zawudui/USB-ParallelPort-Marker-Box/hardware/enclosure/r7.2/snap-fit-pa12/设计说明.md

# C 版：两件一体打印的可拆卡扣外壳

状态：首件试装原型。结构已经按可打印实体设计，实际扣合力、拆装寿命和线缆适配尚需实物确认。

## 送打清单

成品只需打印两件，同一种材料：

| 文件 | 数量 | 内容 |
|---|---:|---|
| `base_r72_snap.stl` | 1 | 底壳、承托柱、定位销、侧向限位块、解锁窗口均一体打印 |
| `lid_r72_snap.stl` | 1 | 上盖、四个弹性卡扣、PCB 上方限位柱、对合定位唇边均一体打印 |

采用 **本色、非增强 PA12 尼龙，MJF 或 SLS**。无需螺丝、螺母、铜柱、泡棉、胶水、垫片、单独卡扣件或表面涂层。正常清粉和去除打印残留属于打印后清理。

STL 单位 mm，100% 比例；底壳和上盖已分别放到 Z=0，上盖已翻转。两件分别打印，不要把 `assembled_r72_snap.step` 作为一整个打印件。STEP 保留 PCB 装配坐标，因此与打印 STL 的姿态不同。

此版卡扣以 PA12 粉末打印为设计工艺；不要直接替换成普通光敏树脂、PLA，或将同一文件视为已经验证过的 FDM/PETG 方案。

## 结构与尺寸

- 合盖外形 **171 × 144 × 33 mm**。相对 B 版加宽 8 mm，为卡扣向内弯曲留空间；PCB 和接口的基准位置沿用原坐标。
- 接口端壁、底板和顶板厚 2.8 mm，两条长侧壁厚 2.6 mm；四个卡扣的弹性臂厚 1.2 mm、宽 8 mm，根部圆角 0.8 mm。弹性臂与背后侧壁之间留 0.6 mm 开放间隙，便于清粉和按压活动。
- 卡扣通过底壳两侧窗口解锁，按钮与壳体一起打印。标号 1、2 表示两组卡扣。
- 对合唇边每侧留 0.4 mm 标称间隙，用于导向和承受横向载荷。
- PCB 下方有四个工艺边承托柱及原主板承托台；两个对角孔采用 Ø1.4 mm 圆定位销和沿孔距方向放松的椭圆定位销，另两个柱只承托。
- 四个上盖限位柱下端 Z=2.05 mm。PCB 标称厚 1.6 mm 时留 0.45 mm 竖向间隙，不要求硬压紧，不使用泡棉。开盖后可以直接取出 PCB。
- 工艺边固定孔来自首板 CAM 数据（交易编号已从公开版移除）：Ø2.05 mm NPTH；外壳坐标为 `(5, 2.5)`、`(145, 2.5)`、`(5, -120.5)`、`(150, -120.5)` mm。承托和上方限位相互对应，避开 V-CUT 切槽。

## 装配与拆卸

1. 先空壳试扣，确认四扣进入窗口、合缝贴合；通过两侧窗口按压卡扣，均匀抬起上盖，确认能拆开。
2. 将 PCB 两个对角定位孔套入定位销，板底落在承托面上。板子应自然放下，不应靠挤压或掰弯工艺边装入。
3. 将上盖唇边对正底壳，沿四个卡扣位置逐步按合，确认四扣均入位。
4. 实际插拔 USB-C、DB25，并确认配套插头外壳和锁紧旋钮有空间。
5. 拆卸时通过侧窗向内按压卡扣并轻抬上盖，可先解除一组、保持该端略微抬起，再解除另一组。不要单侧大角度掀盖，也不要拉扯 PCB。

`optional_coupon/` 下的两个 STL 是从同一套实际卡扣与窗口裁出的可选试配小样。可以先用同一 PA12 工艺打印它们，检查扣合和按压手感；它们不参与成品装配，也不要求额外材料。

## 验证范围

生成程序检查：每件为有效单实体、STL 封闭及法向一致、网格与实体体积一致、合盖无刚性重叠、含真实孔位的工艺边无干涉、DB25 预留包络无干涉，并逐一核对原 PCB STEP 中的元件。

卡扣另有标称梁应变和向内变形空间的初步计算。这不是有限元分析、实际扣合力或疲劳寿命测试；文件中的间隙也不代替打印供应商的实际公差。首件需要实际装配确认。

原 PCB STEP 中 J2、U20 的实体不完整，R99、TP201、TP202、TP203 缺少实体，因此保留原有未验证标记。DB25、USB 配套线缆仍需实物试插。

## 重新生成

在当前工程环境运行：

```text
python hardware/enclosure/r7.2/snap-fit/build_snap_enclosure.py
python hardware/enclosure/r7.2/snap-fit/render_snap_review.py
```

默认生成到 `output/`。`--geometry-only` 只用于结构迭代，其报告标为未完成验证，不作为完整交付。

设计参考：[嘉立创 MJF 工艺说明](https://jlc3dp.com/help/article/what-is-multi-jet-fusion%28mjf%293d-printing)、[Protolabs 卡扣设计指南](https://www.hubs.com/knowledge-base/how-design-snap-fit-joints-3d-printing/)。这些工艺建议用于选定材料、圆角和间隙，具体本壳仍需首件试装。
