zawudui/USB-ParallelPort-Marker-Box/hardware/enclosure/r7.2/snap-fit-pa12/C_latch_section.png

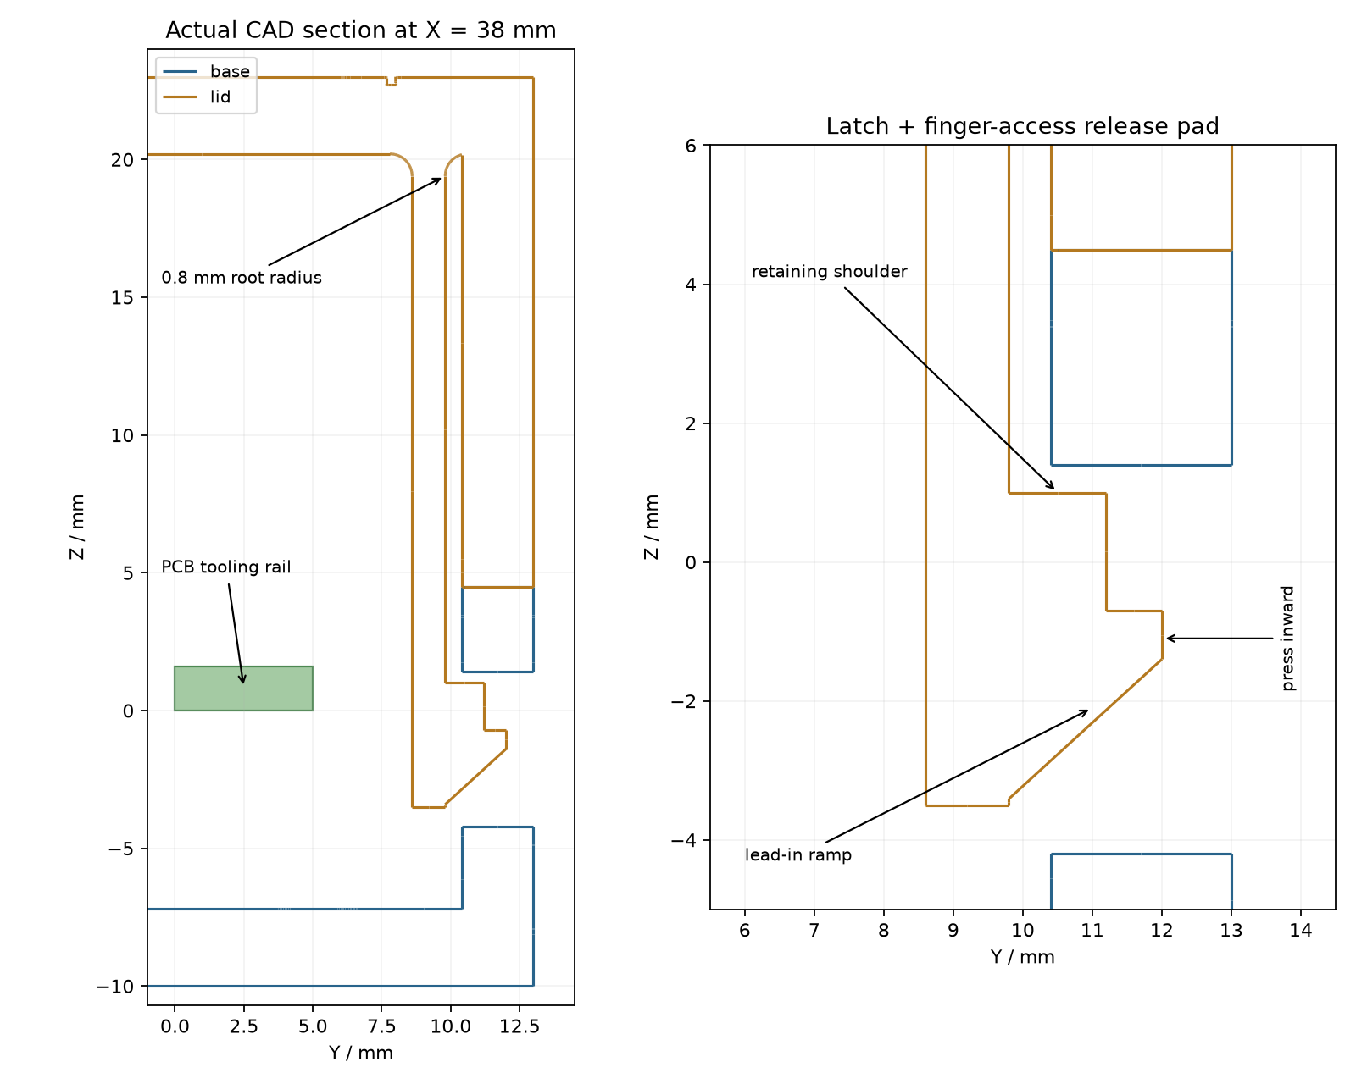
hardware/enclosure/r7.2/snap-fit-pa12/C_latch_section.png
