zawudui/USB-ParallelPort-Marker-Box/hardware/r7.2/manufacturing/bom/usb_db25_marker-bom-r7.2-by-ref.csv

Ref | Value | Footprint
C1 | 100nF | Capacitor_SMD:C_0603_1608Metric
C2 | 100nF | Capacitor_SMD:C_0603_1608Metric
C3 | 100nF | Capacitor_SMD:C_0603_1608Metric
C4 | 4.7uF | Capacitor_SMD:C_0603_1608Metric
C5 | 8.2pF | Capacitor_SMD:C_0603_1608Metric
C6 | 8.2pF | Capacitor_SMD:C_0603_1608Metric
C7 | 2.2uF | Capacitor_SMD:C_0603_1608Metric
C10 | 10uF | Capacitor_SMD:C_0603_1608Metric
C11 | 22uF | Capacitor_SMD:C_0603_1608Metric
C20 | 10uF/25V | Capacitor_SMD:C_0805_2012Metric
C21 | 10uF | Capacitor_SMD:C_0603_1608Metric
C22 | 100nF | Capacitor_SMD:C_0603_1608Metric
C23 | 100nF | Capacitor_SMD:C_0603_1608Metric
C24 | 100nF | Capacitor_SMD:C_0603_1608Metric
C25 | 100nF | Capacitor_SMD:C_0603_1608Metric
C30 | 100nF | Capacitor_SMD:C_0603_1608Metric
C31 | 100nF | Capacitor_SMD:C_0603_1608Metric
C32 | 100nF | Capacitor_SMD:C_0603_1608Metric
C33 | 100nF | Capacitor_SMD:C_0603_1608Metric
C34 | 100nF | Capacitor_SMD:C_0603_1608Metric
C35 | 100nF | Capacitor_SMD:C_0603_1608Metric
C36 | 100nF | Capacitor_SMD:C_0603_1608Metric
C37 | 100nF | Capacitor_SMD:C_0603_1608Metric
C40 | 100nF | Capacitor_SMD:C_0603_1608Metric
C201 | 10uF/25V | Capacitor_SMD:C_0805_2012Metric
C202 | 1uF/16V | Capacitor_SMD:C_0603_1608Metric
C203 | 10uF/25V | Capacitor_SMD:C_0805_2012Metric
C204 | 10uF/25V | Capacitor_SMD:C_0805_2012Metric
C205 | 100nF | Capacitor_SMD:C_0603_1608Metric
C206 | 3.3nF | Capacitor_SMD:C_0603_1608Metric
C207 | 220nF | Capacitor_SMD:C_0603_1608Metric
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
U17 | TPD2E2U06DCKR | Package_TO_SOT_SMD:SOT-323_SC-70
U18 | TPD4E05U06DQAR | Package_SON:USON-10_2.5x1.0mm_P0.5mm
U19 | TPD4E05U06DQAR | Package_SON:USON-10_2.5x1.0mm_P0.5mm
U20 | TPS61085PWR | Package_SO:TSSOP-8_4.4x3mm_P0.65mm
Y1 | 25MHz 8pF NX3225GA | Crystal:Crystal_SMD_3225-4Pin_3.2x2.5mm
