zawudui/USB-ParallelPort-Marker-Box/hardware/enclosure/r7.2/snap-fit-pa12/assembled_r72_snap.step

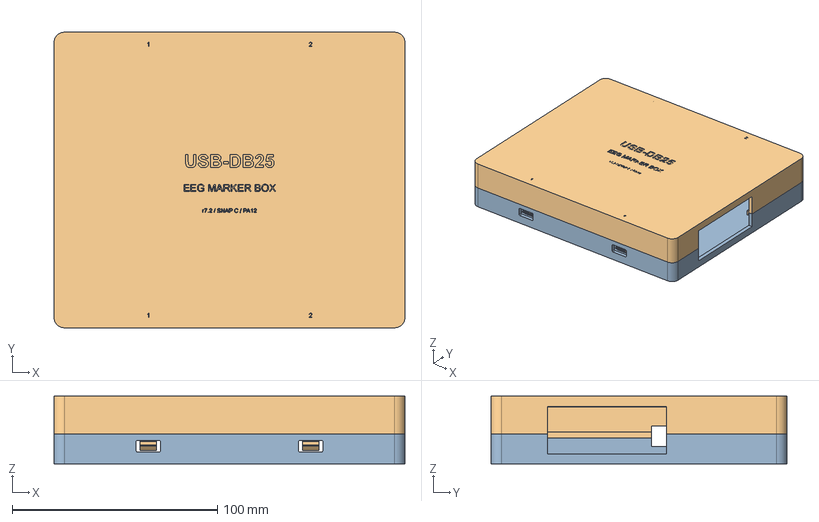
[picture p3: CAD file, 2026-11-09]
hardware/enclosure/r7.2/snap-fit-pa12/assembled_r72_snap.step
171.0 x 144.0 x 33.0 mm
BASE
LID
