zawudui/USB-ParallelPort-Marker-Box/hardware/enclosure/r7.2/first-fit/assembled_enclosure_r72.step

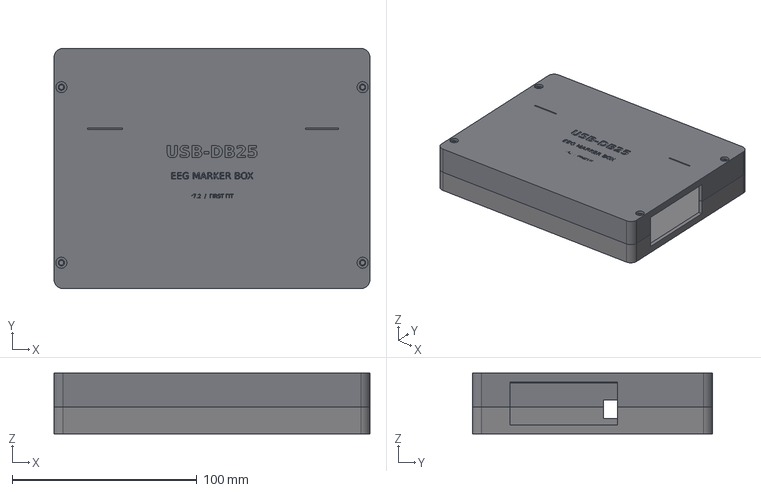
[picture p4: CAD file, 2026-11-09]
hardware/enclosure/r7.2/first-fit/assembled_enclosure_r72.step
171.0 x 130.0 x 33.0 mm
BASE
LID
