zawudui/USB-ParallelPort-Marker-Box/hardware/enclosure/r7.2/snap-fit-pa12/optional_coupon/clip_lid.stl

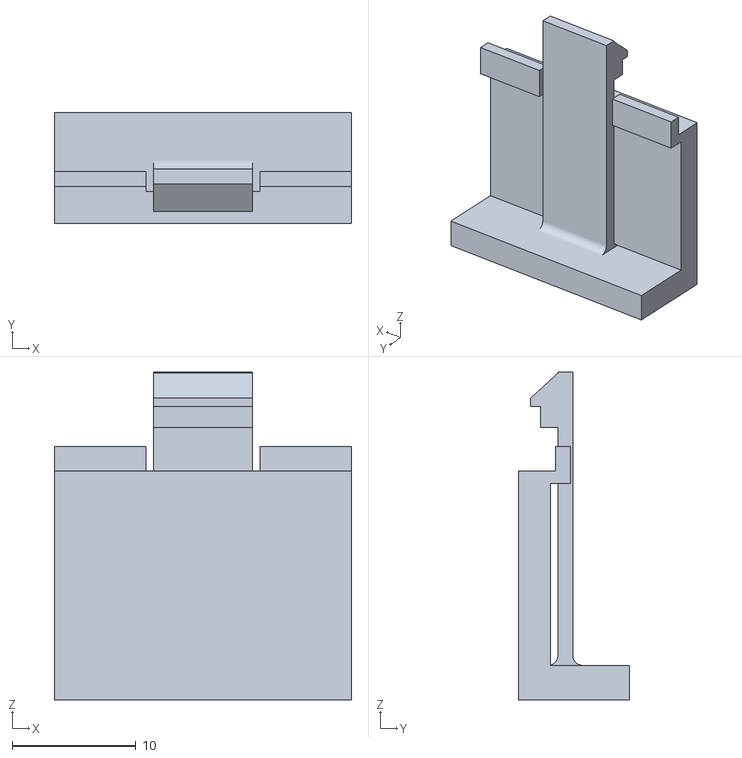
[picture p6: CAD file, 2026-11-09]
hardware/enclosure/r7.2/snap-fit-pa12/optional_coupon/clip_lid.stl
24.0 x 9.00 x 26.5
