zawudui/USB-ParallelPort-Marker-Box/hardware/enclosure/r7.2/snap-fit-pa12/lid_r72_snap.step

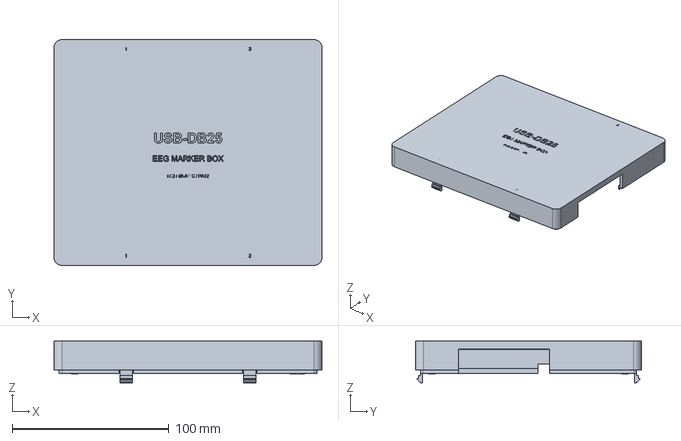
[picture p7: CAD file, 2026-11-09]
hardware/enclosure/r7.2/snap-fit-pa12/lid_r72_snap.step
171.0 x 144.0 x 26.5 mm
