zawudui/USB-ParallelPort-Marker-Box/hardware/enclosure/r7.2/snap-fit-pa12/optional_coupon/clip_base.stl

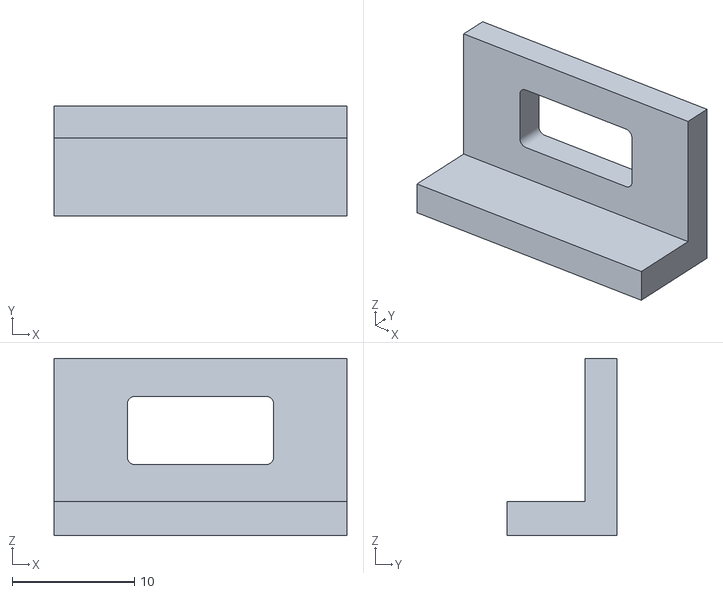
[picture p8: CAD file, 2026-11-09]
hardware/enclosure/r7.2/snap-fit-pa12/optional_coupon/clip_base.stl
24.0 x 9.00 x 14.5
