zawudui/USB-ParallelPort-Marker-Box/hardware/enclosure/r7.2/snap-fit-pa12/base_r72_snap.step

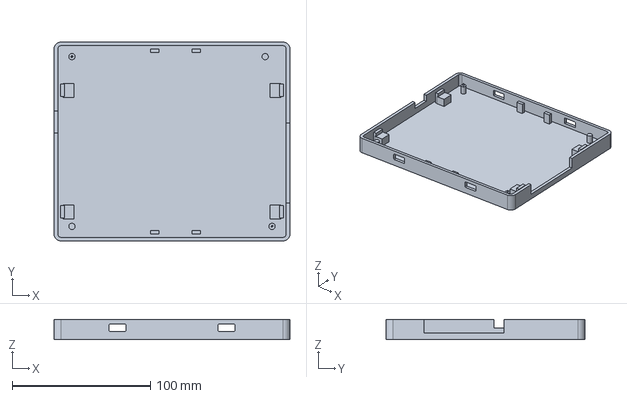
[picture p10: CAD file, 2026-11-09]
hardware/enclosure/r7.2/snap-fit-pa12/base_r72_snap.step
171.0 x 144.0 x 14.5 mm
