zawudui/USB-ParallelPort-Marker-Box/(list of files, cad)

Other CAD files:
hardware/enclosure/r7.2/first-fit/base_r72.stl
hardware/enclosure/r7.2/first-fit/lid_r72.stl
hardware/enclosure/r7.2/snap-fit-pa12/base_r72_snap.stl
hardware/enclosure/r7.2/snap-fit-pa12/lid_r72_snap.stl
