zawudui/USB-ParallelPort-Marker-Box/hardware/r7.2/manufacturing/assembly/assembly-bottom-r7.2.pdf

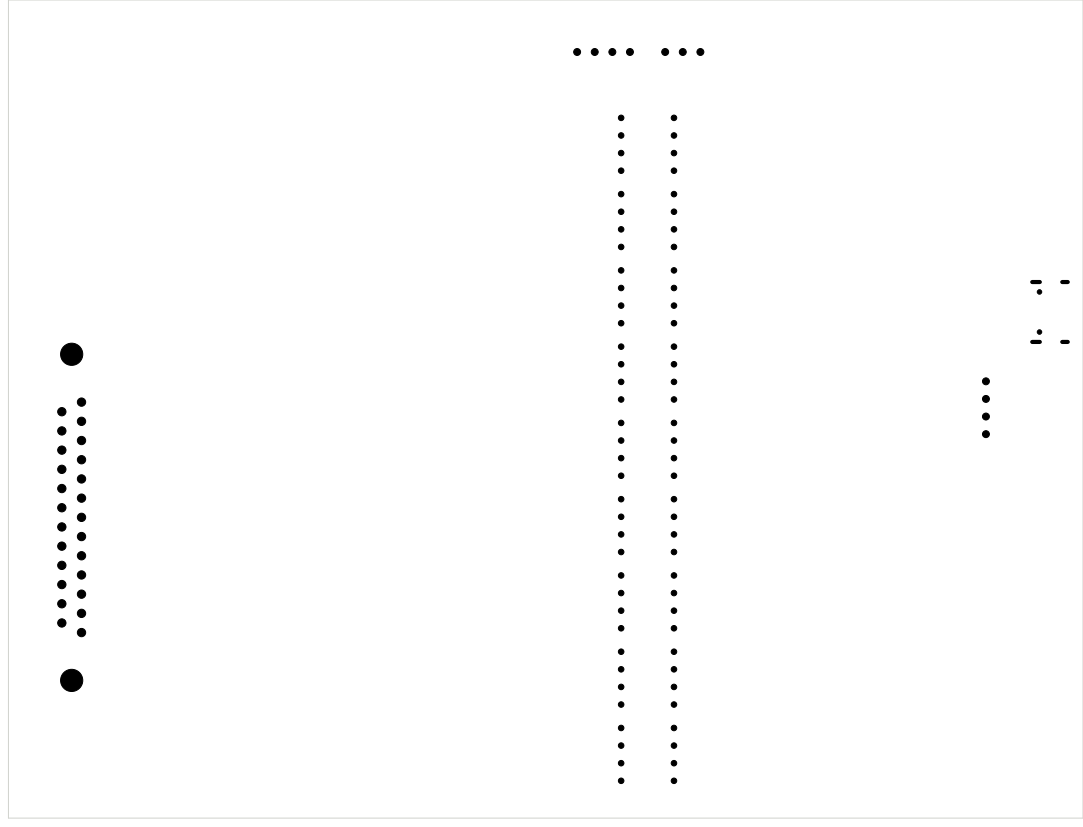
[picture p11: page 1]
