zawudui/USB-ParallelPort-Marker-Box/hardware/r7.2/manufacturing/assembly/assembly-top-r7.2.pdf

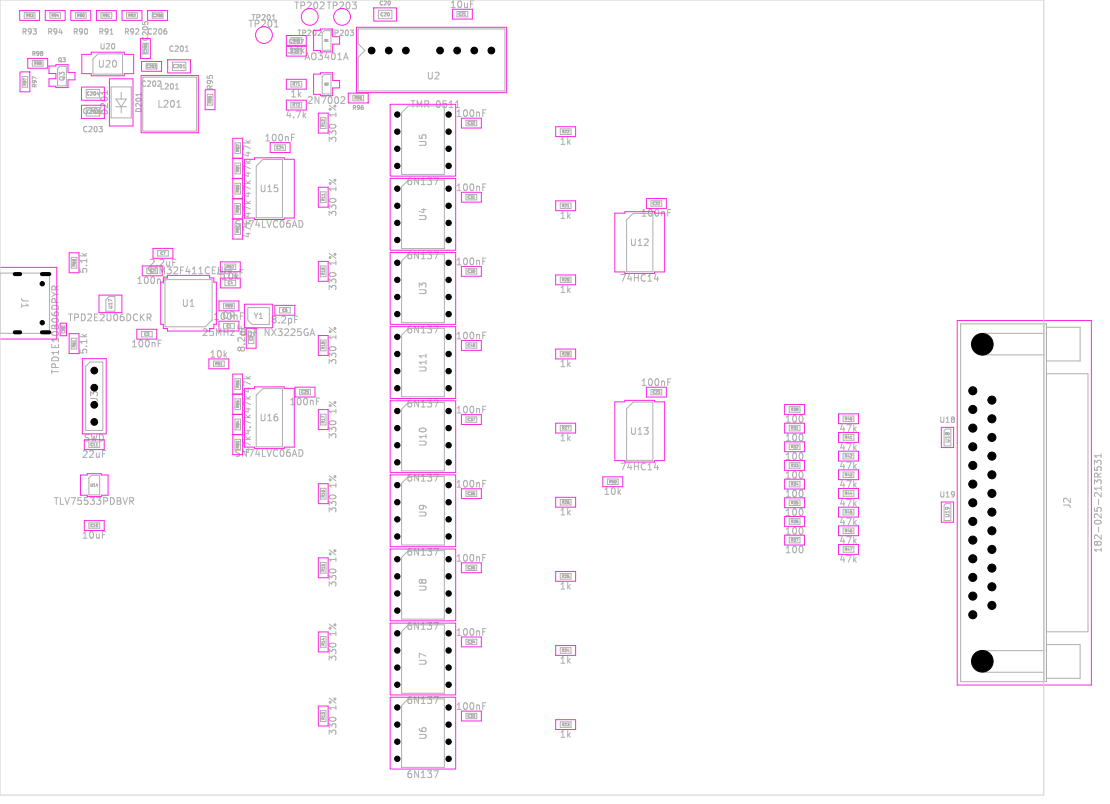
[picture p12: page 1]
