zawudui/USB-ParallelPort-Marker-Box/hardware/r7.2/manufacturing/assembly/pcb-bottom-r7.2.pdf

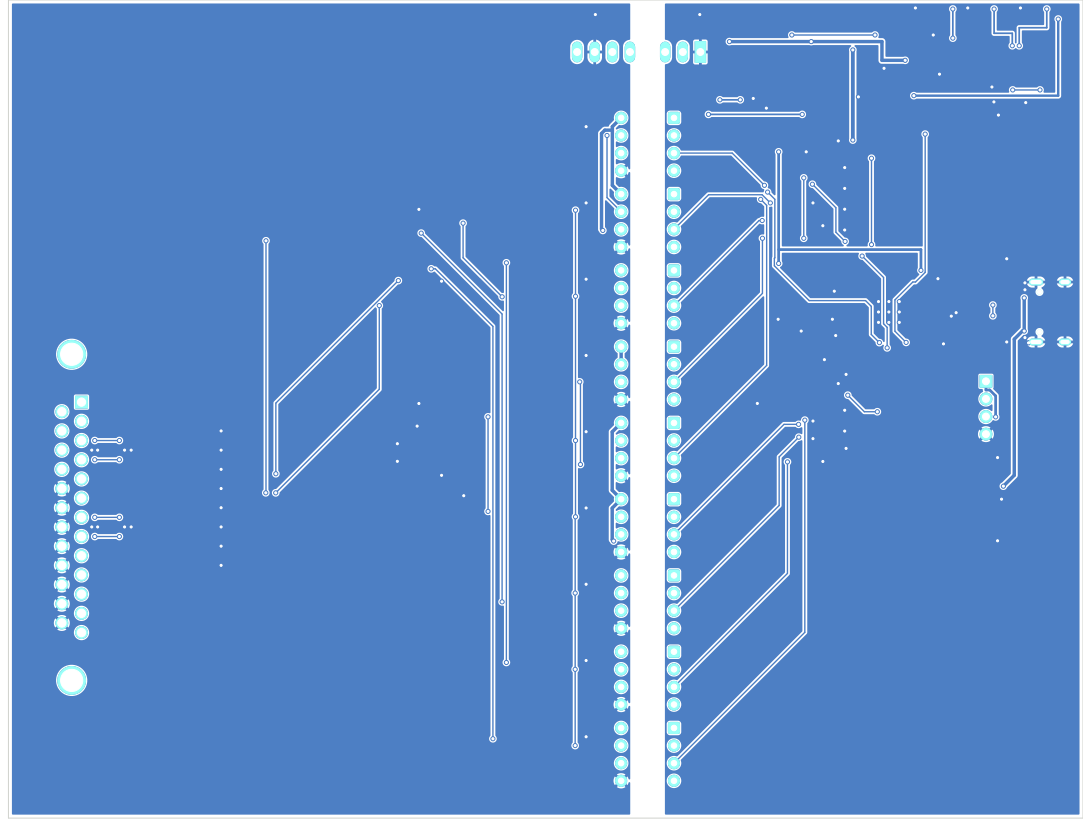
[picture p13: page 1]
