zawudui/USB-ParallelPort-Marker-Box/hardware/r7.2/manufacturing/assembly/pcb-top-r7.2.pdf

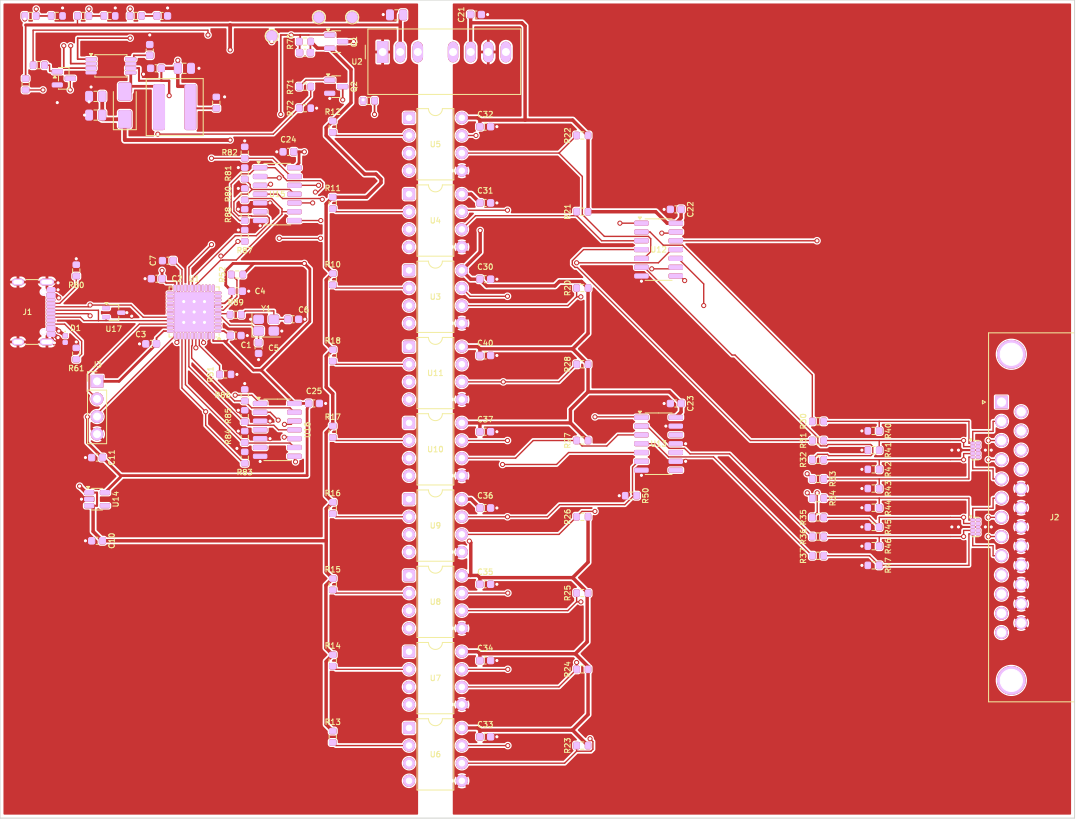
[picture p14: page 1]
