zawudui/USB-ParallelPort-Marker-Box/hardware/r7.2/manufacturing/assembly/schematic-r7.2.pdf

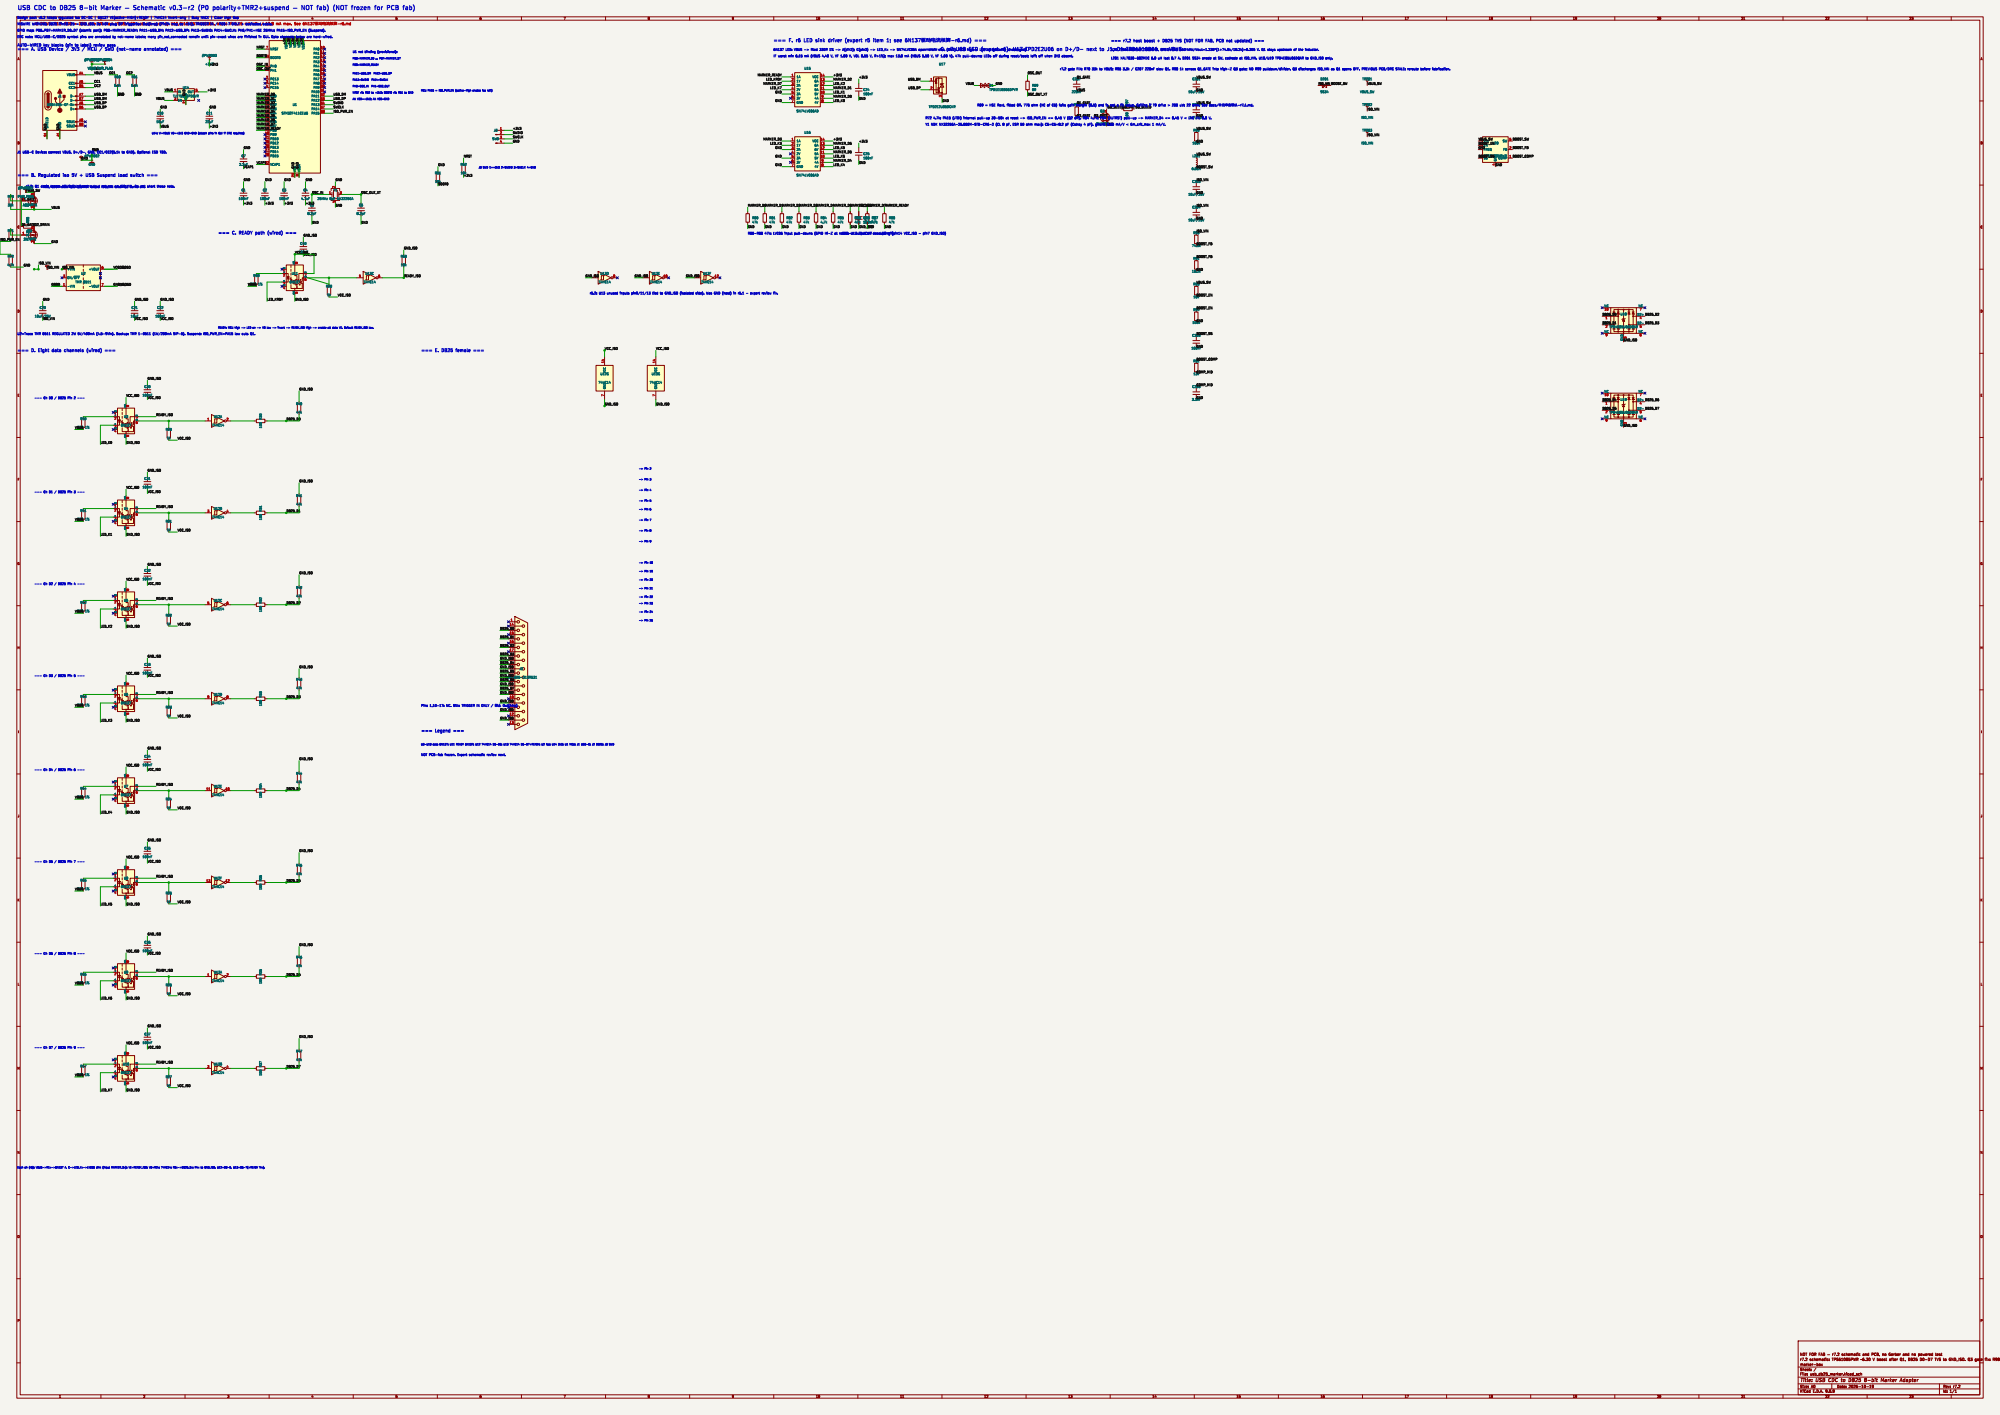
[picture p15: page 1]

1 VDD 24 VDD 36 VSS 23 VDD 48 VSSA
VCC_ISO +3V3
