zawudui/USB-ParallelPort-Marker-Box/hardware/r7.2/kicad/usb_db25_marker.kicad_pcb

## KiCad design hardware/r7.2/kicad/usb_db25_marker.kicad_pcb (2026-11-09)

Schematic: usb_db25_marker.kicad_sch, USB CDC to DB25 8-bit Marker Adapter

Parts:
C1, C2, C3, C22, C23, C24, C25, C30, C31, C32, C33, C34, C35, C36, C37, C40, C205: 100nF; C_0603_1608Metric
C4: 4.7uF; C_0603_1608Metric
C5, C6: 8.2pF; C_0603_1608Metric
C7: 2.2uF; C_0603_1608Metric
C10, C21: 10uF; C_0603_1608Metric
C11: 22uF; C_0603_1608Metric
C20, C201, C203, C204: 10uF/25V; C_0805_2012Metric
C202: 1uF/16V; C_0603_1608Metric
C206: 3.3nF; C_0603_1608Metric
C207: 220nF; C_0603_1608Metric
D1: TPD1E10B06DPYR; D_0402_1005Metric
D201: SS34; D_SMA
J1: USB4105-GF-A; USB_C_Receptacle_GCT_USB4105-xx-A_16P_TopMnt_Horizontal
J2: 182-025-213R531; DSUB-25_Socket_NorComp_182-025-213R531
J3: SWD; PinHeader_1x04_P2.54mm_Vertical
L201: 6.8uH; L_Coilcraft_XAL7030-682
Q1: AO3401A; SOT-23
Q2, Q3: 2N7002; SOT-23
R10, R11, R12, R13, R14, R15, R16, R17, R18: 330 1%; R_0603_1608Metric
R20, R21, R22, R23, R24, R25, R26, R27, R28, R71, R98: 1k; R_0603_1608Metric
R30, R31, R32, R33, R34, R35, R36, R37, R97: 100; R_0603_1608Metric
R40, R41, R42, R43, R44, R45, R46, R47, R80, R81, R82, R83, R85, R86, R87, R88: 47k; R_0603_1608Metric
R50, R51, R52, R93: 10k; R_0603_1608Metric
R60, R61: 5.1k; R_0603_1608Metric
R70: 33k; R_0603_1608Metric
R72, R84: 4.7k; R_0603_1608Metric
R89: 0R; R_0603_1608Metric
R90: 74.5k; R_0603_1608Metric
R91: 18.2k; R_0603_1608Metric
R92: 13k; R_0603_1608Metric
R94, R95: 100k; R_0603_1608Metric
R96: 3.3k; R_0603_1608Metric
TP201: VBUS_SW; TestPoint_Pad_D1.5mm
TP202, TP203: ISO_VIN; TestPoint_Pad_D1.5mm
U1: STM32F411CEU6; QFN-48-1EP_7x7mm_P0.5mm_EP5.6x5.6mm
U2: TMR 0511; TMR2_0511_SIP8
U3, U4, U5, U6, U7, U8, U9, U10, U11: 6N137; DIP-8_W7.62mm
U12, U13: 74HC14; SOIC-14_3.9x8.7mm_P1.27mm
U14: TLV75533PDBVR; SOT-23-5
U15, U16: SN74LVC06AD; SOIC-14_3.9x8.7mm_P1.27mm
U17: TPD2E2U06DCKR; SOT-323_SC-70
U18, U19: TPD4E05U06DQAR; USON-10_2.5x1.0mm_P0.5mm
U20: TPS61085PWR; TSSOP-8_4.4x3mm_P0.65mm
Y1: 25MHz 8pF NX3225GA; Crystal_SMD_3225-4Pin_3.2x2.5mm

Connections:
+3V3: C1.2, C2.2, C3.2, C4.2, C11.2, C24.1, C25.1, J3.1, R52.2, U1.1 (VBAT), U1.9 (VDDA), U1.24 (VDD), U1.36 (VDD), U1.48 (VDD), U14.5 (OUT), U15.14 (VCC), U16.14 (VCC)
/BOOST_COMP: R92.1, U20.1 (COMP)
/BOOST_EN: R93.2, R94.1, U20.3 (EN)
/BOOST_FB: R90.2, R91.1, U20.2 (FB)
/BOOST_SS: C205.1, U20.8 (SS)
/BOOST_SW: D201.2 (A), L201.2, U20.5 (SW)
/BOOT0: R51.2, U1.44 (BOOT0)
/CC1: J1.A5 (CC1), R60.1
/CC2: J1.B5 (CC2), R61.1
/COMP_MID: C206.1, R92.2
/DB25_D0: J2.2, R30.2, R40.2, U18.1 (D1+)
/DB25_D1: J2.3, R31.2, R41.2, U18.2 (D1-)
/DB25_D2: J2.4, R32.2, R42.2, U18.4 (D2+)
/DB25_D3: J2.5, R33.2, R43.2, U18.5 (D2-)
/DB25_D4: J2.6, R34.2, R44.2, U19.1 (D1+)
/DB25_D5: J2.7, R35.2, R45.2, U19.2 (D1-)
/DB25_D6: J2.8, R36.2, R46.2, U19.4 (D2+)
/DB25_D7: J2.9, R37.2, R47.2, U19.5 (D2-)
/GND_ISO: C21.1, C22.1, C23.2, C30.1, C31.1, C32.1, C33.1, C34.1, C35.1, C36.1, C37.1, C40.1, J2.18, J2.19, J2.20, J2.21, J2.22, J2.23, J2.24, J2.25, R40.1, R41.1, R42.1, R43.1, R44.1, R45.1, R46.1, R47.1, R50.1, U2.7 (-VOUT), U3.5 (GND), U4.5 (GND), U5.5 (GND), U6.5 (GND), U7.5 (GND), U8.5 (GND), U9.5 (GND), U10.5 (GND), U11.5 (GND), U12.7 (GND), U13.7 (GND), U13.9, U13.11, U13.13, U18.3 (GND), U18.8 (GND), U19.3 (GND), U19.8 (GND)
/ISO_BLEED: Q3.3 (D), R97.2
/ISO_PWR_EN: R71.2, R72.1, U1.38 (PA15)
/LED_K0: U3.3 (C), U15.8 (4Y)
/LED_K1: U4.3 (C), U15.10 (5Y)
/LED_K2: U5.3 (C), U15.12 (6Y)
/LED_K3: U6.3 (C), U16.2 (1Y)
/LED_K4: U7.3 (C), U16.8 (4Y)
/LED_K5: U8.3 (C), U16.10 (5Y)
/LED_K6: U9.3 (C), U16.12 (6Y)
/LED_K7: U10.3 (C), U15.4 (2Y)
/LED_KRDY: U11.3 (C), U15.2 (1Y)
/MARKER_D0: R80.1, U1.18 (PB0), U15.9 (4A)
/MARKER_D1: R81.1, U1.19 (PB1), U15.11 (5A)
/MARKER_D2: R82.1, U1.20 (PB2), U15.13 (6A)
/MARKER_D3: R83.1, U1.39 (PB3), U16.1 (1A)
/MARKER_D4: R84.1, U1.40 (PB4), U16.9 (4A)
/MARKER_D5: R85.1, U1.41 (PB5), U16.11 (5A)
/MARKER_D6: R86.1, U1.42 (PB6), U16.13 (6A)
/MARKER_D7: R87.1, U1.43 (PB7), U15.3 (2A)
/MARKER_READY: R88.1, U1.45 (PB8), U15.1 (1A)
/NRST: R52.1, U1.7 (NRST)
/OSC_IN: C5.1, U1.5 (PH0), Y1.1
/OSC_OUT: R89.1, U1.6 (PH1)
/OSC_OUT_XT: C6.1, R89.2, Y1.3
/Q1_GATE: C207.1, Q1.1 (G), R70.1, R96.1, R98.1
/Q2_DRAIN: Q2.3 (D), R96.2
/Q3_GATE: Q3.1 (G), R98.2
/READY_ISO: R50.2, U3.7 (EN), U4.7 (EN), U5.7 (EN), U6.7 (EN), U7.7 (EN), U8.7 (EN), U9.7 (EN), U10.7 (EN), U13.6
/SWCLK: J3.3, U1.37 (PA14)
/SWDIO: J3.2, U1.34 (PA13)
/USB_DM: J1.A7 (D-), J1.B7 (D-), U1.32 (PA11), U17.1
/USB_DP: J1.A6 (D+), J1.B6 (D+), U1.33 (PA12), U17.2
/VCAP1: C7.2, U1.22 (VCAP1)
/VCC_ISO: C21.2, C22.2, C23.1, C30.2, C31.2, C32.2, C33.2, C34.2, C35.2, C36.2, C37.2, C40.2, R20.2, R21.2, R22.2, R23.2, R24.2, R25.2, R26.2, R27.2, R28.2, U2.6 (+VOUT), U3.8 (VCC), U4.8 (VCC), U5.8 (VCC), U6.8 (VCC), U7.8 (VCC), U8.8 (VCC), U9.8 (VCC), U10.8 (VCC), U11.7 (EN), U11.8 (VCC), U12.14 (VCC), U13.14 (VCC)
unnamed: Q2.1 (G), R71.1
unnamed: R30.1, U12.2
unnamed: R31.1, U12.4
unnamed: R32.1, U12.6
unnamed: R33.1, U12.8
unnamed: R34.1, U12.10
unnamed: R35.1, U12.12
unnamed: R36.1, U13.2
unnamed: R37.1, U13.4
unnamed: R10.1, U3.2 (A)
unnamed: R20.1, U3.6 (VO), U12.1
unnamed: R11.1, U4.2 (A)
unnamed: R21.1, U4.6 (VO), U12.3
unnamed: R12.1, U5.2 (A)
unnamed: R22.1, U5.6 (VO), U12.5
unnamed: R13.1, U6.2 (A)
unnamed: R23.1, U6.6 (VO), U12.9
unnamed: R14.1, U7.2 (A)
unnamed: R24.1, U7.6 (VO), U12.11
unnamed: R15.1, U8.2 (A)
unnamed: R25.1, U8.6 (VO), U12.13
unnamed: R16.1, U9.2 (A)
unnamed: R26.1, U9.6 (VO), U13.1
unnamed: R17.1, U10.2 (A)
unnamed: R27.1, U10.6 (VO), U13.3
unnamed: R18.1, U11.2 (A)
unnamed: R28.1, U11.6 (VO), U13.5

Notes on the sheet:
r6 DRIVE: R10-R18 = 330 ohm 1% from VBUS; LED cathode sunk by U15/U16 SN74LVC06A. Worst IF 6.15 mA min / 13.8 mA max. See 6N137驱动电流核算-r6.md
USB CDC to DB25 8-bit Marker — Schematic v0.3-r2 (P0 polarity+TMR2+suspend — NOT fab) (NOT frozen for PCB fab)
Design pack v0.3 Adopt: regulated iso DC-DC | 6N137 VE(active-HIGH)+READY | 74HC14 invert-only | Busy NACK | Clear then Gap
MISWIRE WARNING: DB25 Pin18-25 = GND_ISO. Do NOT plug BP TriggerBox Out(Amp) (Pin24 may be +5V). TRIGGER IN / PC0-7 ONLY + dedicated cable.
GPIO map: PB0..PB7=MARKER_D0..D7 (atomic port); PB8=MARKER_READY; PA11=USB_DM; PA12=USB_DP; PA13=SWDIO; PA14=SWCLK; PH0/PH1=HSE 25MHz; PA15=ISO_PWR_EN (Suspend).
ERC note: MCU/USB-C/DB25 symbol pins are annotated by net-name labels; many pin_not_connected remain until pin-exact wires are finished in GUI. Opto channels below are hard-wired.
=== A. USB Device / 3V3 / MCU / SWD (net-name annotated) ===
J1 USB-C Device: connect VBUS, D+/D-, GND, CC1/CC2(5.1k to GND). Optional ESD TBD.
U14: VI=VBUS VO=+3V3 GND=GND (attach pins in GUI if ERC requires)
U1 net binding (provisional):
PB0=MARKER_D0 ... PB7=MARKER_D7
PB8=MARKER_READY
PA11=USB_DM PA12=USB_DP
PA13=SWDIO PA14=SWCLK
PH0=OSC_IN PH1=OSC_OUT
NRST via R52 to +3V3; BOOT0 via R51 to GND
All VDD=+3V3; All VSS=GND
J3 SWD 1=+3V3 2=SWDIO 3=SWCLK 4=GND
=== B. Regulated iso 5V + USB Suspend load switch ===
U2=Traco TMR 0511 REGULATED 2W 5V/400mA (4.5-9Vin). Backup: TMR 1-0511 (1W/200mA SIP-6). Suspend: ISO_PWR_EN=PA15 low cuts Q1.
MCU PA15 = ISO_PWR_EN (active-high enable iso rail)
=== C. READY path (wired) ===
READY: MCU high -> LED on -> VO low -> invert -> READY_ISO high -> enable all data VE. Default READY_ISO low.
=== D. Eight data channels (wired) ===
--- Ch D0 / DB25 Pin 2 ---
--- Ch D1 / DB25 Pin 3 ---
--- Ch D2 / DB25 Pin 4 ---
--- Ch D3 / DB25 Pin 5 ---
--- Ch D4 / DB25 Pin 6 ---
--- Ch D5 / DB25 Pin 7 ---
--- Ch D6 / DB25 Pin 8 ---
--- Ch D7 / DB25 Pin 9 ---
Each ch (r6): VBUS->R1x->6N137 A, C->LED_Kx->LVC06 sink (input MARKER_Dx); VE=READY_ISO; VO+R2x; 74HC14; R3x->DB25_Dx; R4x to GND_ISO. U12=D0-5, U13=D6-7(+READY inv).
=== E. DB25 female ===
-> Pin 2
-> Pin 3
-> Pin 4
-> Pin 5
-> Pin 6
-> Pin 7
-> Pin 8
-> Pin 9
-> Pin 18
-> Pin 19
-> Pin 20
-> Pin 21
-> Pin 22
-> Pin 23
-> Pin 24
-> Pin 25
Pins 1,10-17: NC. Silk: TRIGGER IN ONLY / 禁止 Out(Amp)
=== Legend ===
U3-U10 data 6N137; U11 READY 6N137; U12 74HC14 D0-D5; U13 74HC14 D6-D7+READY; U2 iso; U14 3V3; U1 MCU; J1 USB-C; J2 DB25; J3 SWD
NOT PCB-fab frozen. Expert schematic review next.
AUTO-WIRED key blocks (pin to label) review pass
r5.2: U13 unused inputs pin9/11/13 tied to GND_ISO (isolated side). Was GND (host) in r5.1 - expert review fix.
=== F. r6 LED sink driver (expert r5 item 1; see 6N137驱动电流核算-r6.md) ===
6N137 LED: VBUS -> Rled 330R 1% -> A(pin2); C(pin3) -> LED_Kx -> SN74LVC06A open-drain sink (GND). MCU high = LED on (polarity unchanged).
IF worst min 6.15 mA (VBUS 4.40 V, VF 1.80 V, VOL 0.55 V, R+1%); max 13.8 mA (VBUS 5.50 V, VF 1.00 V). 47k pull-downs: LEDs off during reset/boot; Ioff: off when 3V3 absent.
C23: U13 74HC14 decoupling (pin14 VCC_ISO - pin7 GND_ISO)
R80-R88 47k: LVC06 input pull-downs (GPIO Hi-Z at reset -> output off -> LED off)
=== G. r7 USB ESD (expert r6): U17 TPD2E2U06 on D+/D- next to J1, D1 TPD1E10B06 on VBUS ===
R72 4.7k: PA15 (JTDI) internal pull-up 30-50k at reset -> ISO_PWR_EN <= 0.45 V (Q2 off). R84 4.7k: PB4 (NJTRST) pull-up -> MARKER_D4 <= 0.45 V < LVC VIL 0.8 V.
Y1 NDK NX3225GA-25.000M-STD-CRG-2 (CL 8 pF, ESR 50 ohm max): C5=C6=8.2 pF (Cstray 4 pF). gmcrit 0.60 mA/V < Gm_crit_max 1 mA/V.
R89 = HSE Rext, fitted 0R. 776 ohm (XC of C6) fails gain margin (0.5) and is not a fit value. Ceiling if T9 drive > 200 uW: 22 ohm. See docs/补充审查确认-r7.1.md.
r7.2: Q1 drain leaves VBUS_SW. Boost output returns on ISO_VIN. Do not short these nets.
=== r7.2 host boost + DB25 TVS (NOT FOR FAB, PCB not updated) ===
U20 TPS61085PWR TSSOP-8, FREQ=GND 650 kHz, Vout=1.238*(1+74.5k/18.2k)=6.305 V. Q1 stays upstream of the inductor.
L201 XAL7030-682MEC 6.8 uH Isat 8.7 A. D201 SS34 anode at SW, cathode at ISO_VIN. U18/U19 TPD4E05U06DQAR to GND_ISO only.
r7.2 gate FIX: R70 33k to VBUS; R96 3.3k / C207 220nF slew Q1. R98 1k senses Q1_GATE into high-Z Q3 gate; NO R99 pulldown/divider. Q3 discharges ISO_VIN as Q1 opens OFF. PREVIOUS PCB/DRC STALE: reroute before fabrication.
R96/C207 slew Q1. Q3/R97 bleed ISO_VIN after Q1 turns off.

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
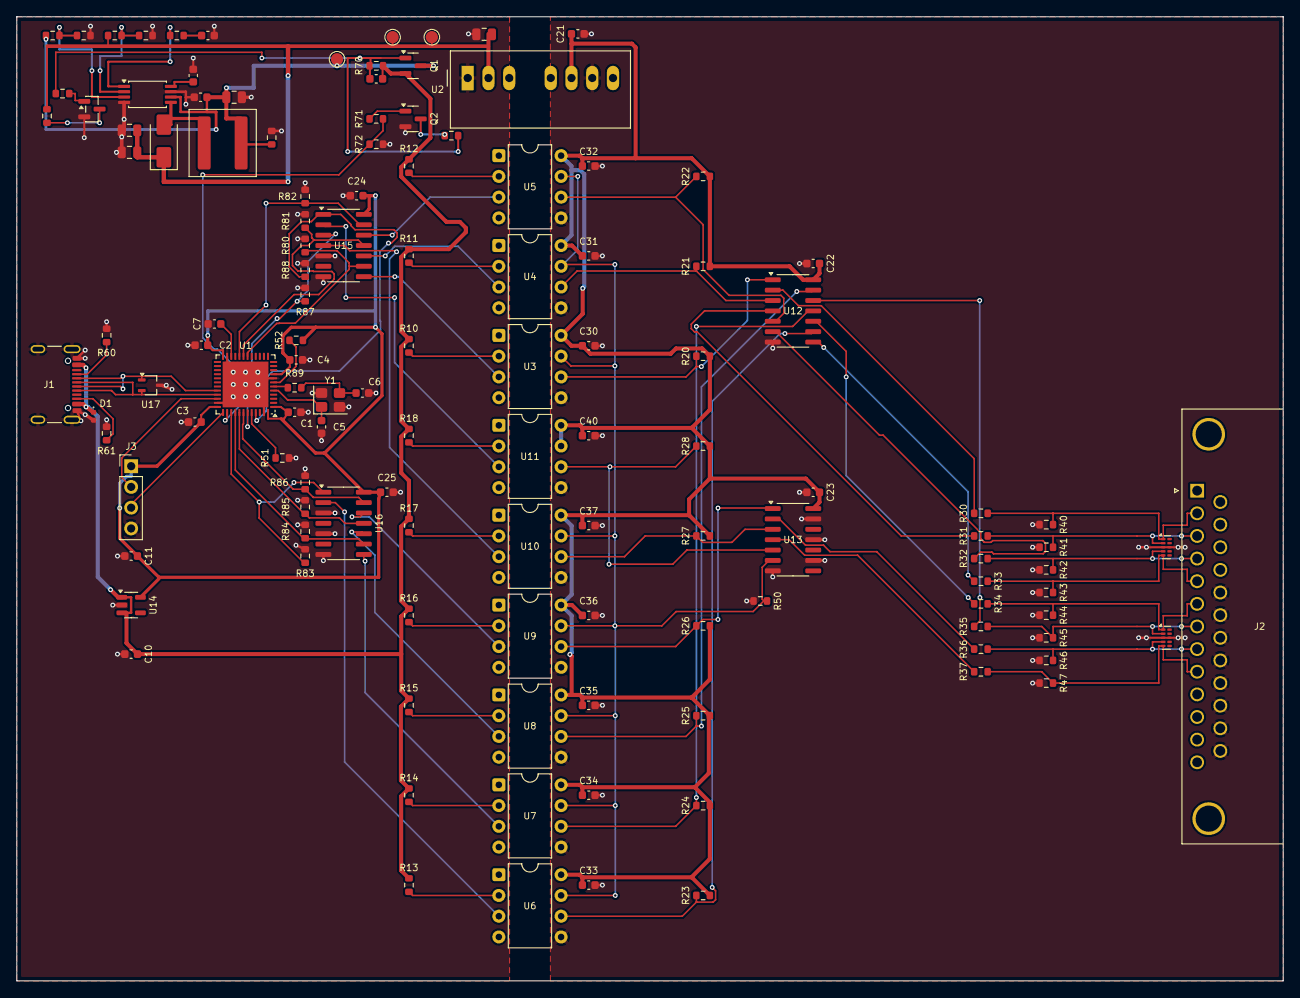
[picture p16: board usb_db25_marker.kicad_pcb from above]

Board: 2 copper layers, 155.0 x 118.0 mm, 125 parts (0 on the bottom side), 84 nets.
